EmbMonkAI/offline_prog_open/PCB010-V3.0.pdf

PB12 33 PB13 34 PB14 35 PB15 36 PC6 37 PC7 38 PC8 39 PC9 40 PA8 41 PA9 42 PA10 43 PA11 44 PA12 45 PA13 (JTMSSWDIO) 46 VSS 47 VDD 48 PA¹⁴ ⁽JTCKSWCLK⁾ ⁴⁹ PA¹⁵ ⁽JTDI) 50

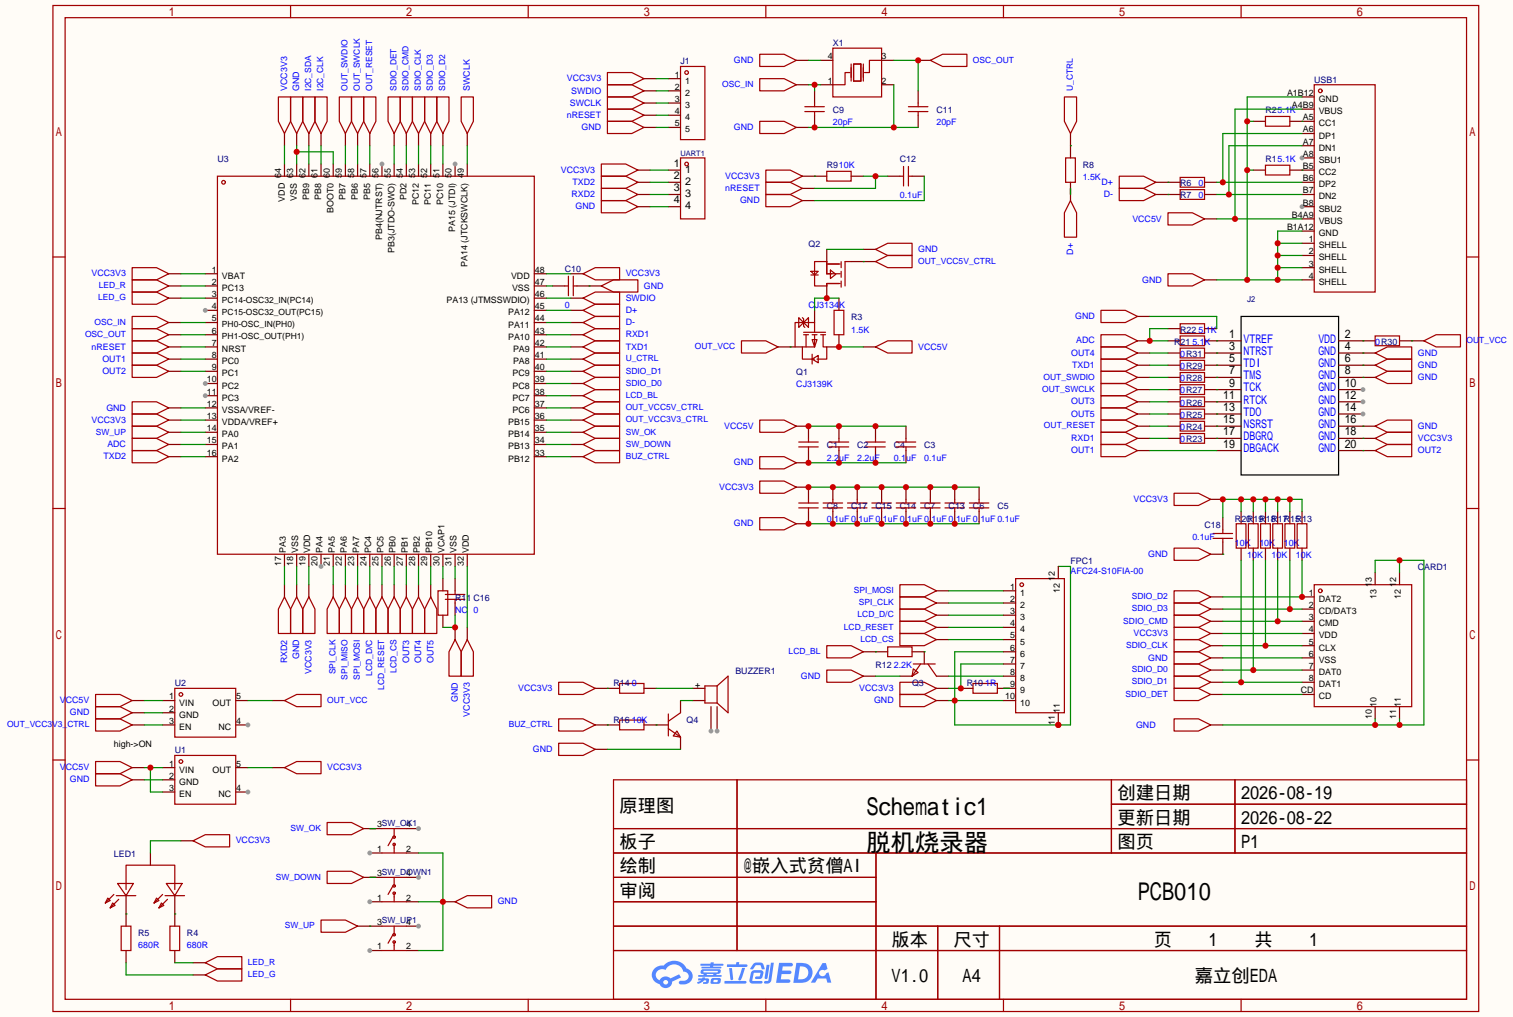
[picture p1: page 1]

原理图 | Schematic1 | 创建日期 | 2026-08-19

更新日期 | 2026-08-22

板子 | 脱机烧录器 | 图页 | P1
绘制 | @嵌入式贫僧AI | PCB010
审阅

V1.0 | A4 | 嘉立创EDA
