EmbMonkAI/offline_prog_open/stm32f401_proj/Core/Inc/main.h

#define LED_R_Pin GPIO_PIN_13
#define LED_R_GPIO_Port GPIOC
#define LED_G_Pin GPIO_PIN_14
#define LED_G_GPIO_Port GPIOC
#define LCD_SDA_Pin GPIO_PIN_4
#define LCD_SDA_GPIO_Port GPIOC
#define LCD_SDAC5_Pin GPIO_PIN_5
#define LCD_SDAC5_GPIO_Port GPIOC
#define LCD_A0_Pin GPIO_PIN_0
#define LCD_A0_GPIO_Port GPIOB
#define LCD_CS_Pin GPIO_PIN_1
#define LCD_CS_GPIO_Port GPIOB
#define LCD_RST_Pin GPIO_PIN_2
#define LCD_RST_GPIO_Port GPIOB
#define USB_CTRL_Pin GPIO_PIN_8
#define USB_CTRL_GPIO_Port GPIOA
#define BUTTON_Pin GPIO_PIN_15
#define BUTTON_GPIO_Port GPIOA
#define SDIO_DET_Pin GPIO_PIN_3
#define SDIO_DET_GPIO_Port GPIOB
#define SWCLK_Pin GPIO_PIN_8
#define SWCLK_GPIO_Port GPIOB
#define SWDIO_Pin GPIO_PIN_9
#define SWDIO_GPIO_Port GPIOB
