EmbMonkAI/offline_prog_open/stm32f401_proj/Core/Src/main.c

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
/* Includes ------------------------------------------------------------------*/
#include "main.h"
#include "fatfs.h"
#include "usb_device.h"

/* USER CODE BEGIN Includes */
#include "app_main.h"
/* USER CODE END Includes */

SD_HandleTypeDef hsd;

SPI_HandleTypeDef hspi1;

TIM_HandleTypeDef htim2;

UART_HandleTypeDef huart1;

void SystemClock_Config(void);
static void MX_GPIO_Init(void);
static void MX_SDIO_SD_Init(void);
static void MX_SPI1_Init(void);
static void MX_USART1_UART_Init(void);
static void MX_TIM2_Init(void);
/**
  * @brief  The application entry point.
  * @retval int
  */
int main(void)
{

  /* MCU Configuration--------------------------------------------------------*/

  /* Reset of all peripherals, Initializes the Flash interface and the Systick. */
  HAL_Init();

  /* Configure the system clock */
  SystemClock_Config();

  /* Initialize all configured peripherals */
  MX_GPIO_Init();
  MX_SDIO_SD_Init();
  MX_SPI1_Init();
  MX_USART1_UART_Init();
  MX_TIM2_Init();
  MX_FATFS_Init();
  MX_USB_DEVICE_Init();
  /* USER CODE BEGIN 2 */
	  HAL_GPIO_WritePin(USB_CTRL_GPIO_Port, USB_CTRL_Pin, GPIO_PIN_SET);

  /* 复位源打印（IWDG/欠压/软复位一眼分辨，产线诊断用）*/
  {
    uint32_t csr = RCC->CSR;
    const char *src = (csr & (1U << 24)) ? "IWDG" :
                      (csr & (1U << 19)) ? "WWDG" :
                      (csr & (1U << 26)) ? "SOFT" :
                      (csr & (1U << 28)) ? "POR" : "?";
    {   /* 必须 bsp_uart_log：裸 printf 无调试器时走半主机会挂死（实测教训）*/
        extern int bsp_uart_log(const char *fmt, ...);
        bsp_uart_log("[RST] src=%s csr=%08lX\n", src, (unsigned long)csr);
    }
  }
  app_main_init();   /* 应用层初始化：装配 LED 设备等 */
  /* USER CODE END 2 */

  /* Infinite loop */
  /* USER CODE BEGIN WHILE */
  while (1)
  {
    /* USER CODE END WHILE */

    /* USER CODE BEGIN 3 */
    app_main_loop();   /* 应用层主循环：LED 闪烁等 */
  }
  /* USER CODE END 3 */
}

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
