EmbMonkAI/offline_prog_open/dap/DAP_config.h

#ifndef __DAP_CONFIG_H__
#define __DAP_CONFIG_H__


#define CPU_CLOCK               84000000        ///< Specifies the CPU Clock in Hz (本工程 STM32F401 @ 84MHz)


#define IO_PORT_WRITE_CYCLES    2               ///< I/O Cycles: 2=default, 1=Cortex-M0+ fast I/0


#define DAP_SWD                 1               ///< SWD Mode:  1 = available, 0 = not available

#define DAP_JTAG                0               ///< JTAG Mode: 0 = not available

#define DAP_JTAG_DEV_CNT        8               ///< Maximum number of JTAG devices on scan chain

#define DAP_DEFAULT_PORT        1               ///< Default JTAG/SWJ Port Mode: 1 = SWD, 2 = JTAG.

#define DAP_DEFAULT_SWJ_CLOCK   10000000         ///< Default SWD/JTAG clock frequency in Hz.


/// Maximum Package Size for Command and Response data.
#define DAP_PACKET_SIZE         64              ///< USB: 64 = Full-Speed, 1024 = High-Speed.

/// Maximum Package Buffers for Command and Response data.
#define DAP_PACKET_COUNT        1              ///< Buffers: 64 = Full-Speed, 4 = High-Speed.


/// Indicate that UART Serial Wire Output (SWO) trace is available.
#define SWO_UART                0               ///< SWO UART:  1 = available, 0 = not available

#define SWO_UART_MAX_BAUDRATE   10000000U       ///< SWO UART Maximum Baudrate in Hz

/// Indicate that Manchester Serial Wire Output (SWO) trace is available.
#define SWO_MANCHESTER          0               ///< SWO Manchester:  1 = available, 0 = not available

#define SWO_BUFFER_SIZE         4096U           ///< SWO Trace Buffer Size in bytes (must be 2^n)


/// Debug Unit is connected to fixed Target Device.
#define TARGET_DEVICE_FIXED     0               ///< Target Device: 1 = known, 0 = unknown;



//**************************************************************************************************
/**
JTAG I/O Pin                 | SWD I/O Pin          | CMSIS-DAP Hardware pin mode
---------------------------- | -------------------- | ---------------------------------------------
TCK: Test Clock              | SWCLK: Clock         | Output Push/Pull
TMS: Test Mode Select        | SWDIO: Data I/O      | Output Push/Pull; Input (for receiving data)
TDI: Test Data Input         |                      | Output Push/Pull
TDO: Test Data Output        |                      | Input
nTRST: Test Reset (optional) |                      | Output Open Drain with pull-up resistor
nRESET: Device Reset         | nRESET: Device Reset | Output Open Drain with pull-up resistor

DAP Hardware I/O Pin Access Functions
*/
#define 	F1XX_PLATFORM		0

#if (F1XX_PLATFORM)
#include "stm32f10x.h"
// Configure DAP I/O pins ------------------------------
#define SWD_GPIO   	GPIOB
#define PIN_SWCLK  	GPIO_Pin_13
#define PIN_SWDIO  	GPIO_Pin_14
#else
#include "stm32f4xx_hal.h"
#define SWD_GPIO   	GPIOB
#define PIN_SWCLK  	GPIO_PIN_6    /* OUT_SWCLK, PB6（PCB010-V3.0） */
#define PIN_SWDIO  	GPIO_PIN_7    /* OUT_SWDIO, PB7（PCB010-V3.0） */
#define PIN_nRESET  GPIO_PIN_5    /* OUT_RESET, PB5（PCB010-V3.0，低有效） */

#define 	PORT_NBR			9
#endif

/** Setup JTAG I/O pins: TCK, TMS, TDI, TDO, nTRST, and nRESET.
 - TCK, TMS, TDI, nTRST, nRESET to output mode and set to high level.
 - TDO to input mode.
*/
static void PORT_JTAG_SETUP(void)
{
#if (DAP_JTAG != 0)
#endif
}

/** Setup SWD I/O pins: SWCLK, SWDIO, and nRESET.
 - SWCLK, SWDIO, nRESET to output mode and set to default high level.
*/
static void PORT_SWD_SETUP(void)
{
#if (F1XX_PLATFORM)	
    GPIO_InitTypeDef GPIO_InitStruct;
	
	SWD_GPIO->BSRR = PIN_SWCLK | PIN_SWDIO;
	
	GPIO_InitStruct.GPIO_Pin = PIN_SWCLK | PIN_SWDIO;
	GPIO_InitStruct.GPIO_Mode = GPIO_Mode_Out_PP;
	GPIO_InitStruct.GPIO_Speed = GPIO_Speed_50MHz;
	GPIO_Init(SWD_GPIO, &GPIO_InitStruct);
	#else
  GPIO_InitTypeDef GPIO_InitStruct = {0};

  /* GPIO Ports Clock Enable */
	SWD_GPIO->BSRR = PIN_SWCLK | PIN_SWDIO | PIN_nRESET;   /* SWCLK/SWDIO/nRESET 默认高 */

  GPIO_InitStruct.Pin = PIN_SWCLK | PIN_SWDIO | PIN_nRESET;
  GPIO_InitStruct.Mode = GPIO_MODE_OUTPUT_PP;
  GPIO_InitStruct.Pull = GPIO_NOPULL;
  GPIO_InitStruct.Speed = GPIO_SPEED_FREQ_HIGH;
  HAL_GPIO_Init(SWD_GPIO, &GPIO_InitStruct);

	
	#endif	
}

/** Disable JTAG/SWD I/O Pins.
 - TCK/SWCLK, TMS/SWDIO, TDI, TDO, nTRST, nRESET to High-Z mode.
*/
static void PORT_OFF(void)
{
	#if (F1XX_PLATFORM)	
	GPIO_InitTypeDef GPIO_InitStruct;
	
	GPIO_InitStruct.GPIO_Pin = PIN_SWCLK | PIN_SWDIO;
	GPIO_InitStruct.GPIO_Mode = GPIO_Mode_IN_FLOATING;
	GPIO_Init(SWD_GPIO, &GPIO_InitStruct);
	#else
  GPIO_InitTypeDef GPIO_InitStruct = {0};
	
  GPIO_InitStruct.Pin = PIN_SWCLK |PIN_SWDIO;
  GPIO_InitStruct.Mode = GPIO_MODE_ANALOG;
  GPIO_InitStruct.Pull = GPIO_NOPULL;
  HAL_GPIO_Init(SWD_GPIO, &GPIO_InitStruct);		
	
	#endif	
}


// SWCLK/TCK I/O pin -------------------------------------

// Current status of the SWCLK/TCK DAP hardware I/O pin
static __inline uint32_t PIN_SWCLK_TCK_IN(void)
{
    return (SWD_GPIO->ODR & PIN_SWCLK) ? 1 : 0;
}

static __inline void PIN_SWCLK_TCK_SET(void)
{
	SWD_GPIO->BSRR = PIN_SWCLK;
}

static __inline void PIN_SWCLK_TCK_CLR(void)
{
	#if (F1XX_PLATFORM)	
    SWD_GPIO->BRR  = PIN_SWCLK;
	#else
		SWD_GPIO->BSRR = (uint32_t)(PIN_SWCLK <<16);
	#endif
}


// SWDIO/TMS Pin I/O --------------------------------------

// Current status of the SWDIO/TMS DAP hardware I/O pin
static __inline uint32_t PIN_SWDIO_TMS_IN(void)
{
    return (SWD_GPIO->IDR & PIN_SWDIO) ? 1 : 0;
}

static __inline void PIN_SWDIO_TMS_SET(void)
{
    SWD_GPIO->BSRR = PIN_SWDIO;
}

static __inline void PIN_SWDIO_TMS_CLR(void)
{
	#if (F1XX_PLATFORM)	
    SWD_GPIO->BRR  = PIN_SWDIO;
	#else
		SWD_GPIO->BSRR = (uint32_t)(PIN_SWDIO <<16);
	#endif	
}


static __inline uint32_t PIN_SWDIO_IN(void)
{
    return (SWD_GPIO->IDR & PIN_SWDIO) ? 1 : 0;
}

static __inline void PIN_SWDIO_OUT(uint32_t bit)
{
    if(bit & 1) SWD_GPIO->BSRR = PIN_SWDIO;
    else
			#if (F1XX_PLATFORM)	
			SWD_GPIO->BRR  = PIN_SWDIO;
			#else
			SWD_GPIO->BSRR = (uint32_t)(PIN_SWDIO <<16);
			#endif		
}

static __inline void PIN_SWDIO_OUT_ENABLE(void)
{
#if (F1XX_PLATFORM)	
	SWD_GPIO->CRH &= ~(0xF << (14 - 8) * 4);
  SWD_GPIO->CRH |=  (0x3 << (14 - 8) * 4);
	SWD_GPIO->BRR  = PIN_SWDIO;
#else

  GPIO_InitTypeDef GPIO_InitStruct = {0};	
  GPIO_InitStruct.Pin = PIN_SWDIO;
  GPIO_InitStruct.Mode = GPIO_MODE_OUTPUT_PP;
	GPIO_InitStruct.Speed = GPIO_SPEED_FREQ_MEDIUM;	
  HAL_GPIO_Init(SWD_GPIO, &GPIO_InitStruct);
	SWD_GPIO->BSRR  = PIN_SWDIO<<16;
#endif
}

static __inline void PIN_SWDIO_OUT_DISABLE(void)
{
#if (F1XX_PLATFORM)	
  SWD_GPIO->CRH &= ~(0xF << (14 - 8) * 4);
	SWD_GPIO->CRH |=  (0x8 << (14 - 8) * 4);
	SWD_GPIO->BSRR = PIN_SWDIO;
#else
	
  GPIO_InitTypeDef GPIO_InitStruct = {0};
  GPIO_InitStruct.Pin = PIN_SWDIO;
  GPIO_InitStruct.Mode = GPIO_MODE_INPUT;
	GPIO_InitStruct.Speed = GPIO_SPEED_FREQ_MEDIUM;	
  HAL_GPIO_Init(SWD_GPIO, &GPIO_InitStruct);
	SWD_GPIO->BSRR = PIN_SWDIO;	
#endif	
}


// TDI Pin I/O ---------------------------------------------

static __inline uint32_t PIN_TDI_IN(void)
{
#if (DAP_JTAG != 0)
#endif
	return 0;
}

static __inline void PIN_TDI_OUT(uint32_t bit)
{
#if (DAP_JTAG != 0)
#endif
}


// TDO Pin I/O ---------------------------------------------

static __inline uint32_t PIN_TDO_IN(void)
{
#if (DAP_JTAG != 0)
#endif
	return 0;
}


// nTRST Pin I/O -------------------------------------------

static __inline uint32_t PIN_nTRST_IN(void)
{
    return 0;
}

static __inline void PIN_nTRST_OUT(uint32_t bit)
{
}

// nRESET Pin I/O------------------------------------------  目标硬复位 nRESET, PB7(低有效)
static __inline uint32_t PIN_nRESET_IN(void)
{
    return (SWD_GPIO->IDR & PIN_nRESET) ? 1 : 0;
}

static __inline void PIN_nRESET_OUT(uint32_t bit)
{
    if (bit & 1) SWD_GPIO->BSRR = PIN_nRESET;           /* 1=释放复位(高) */
    else         SWD_GPIO->BSRR = (PIN_nRESET << 16);   /* 0=复位(低) */
}


//**************************************************************************************************
/** Connect LED: is active when the DAP hardware is connected to a debugger
    Running LED: is active when program execution in target started
*/

static __inline void LED_CONNECTED_OUT(uint32_t bit)
{
}

static __inline void LED_RUNNING_OUT(uint32_t bit)
{
}



static void DAP_SETUP(void)
{
	#if (F1XX_PLATFORM)
	RCC_APB2PeriphClockCmd(RCC_APB2Periph_GPIOB, ENABLE);
	#endif
	
	PORT_OFF();
}


static uint32_t RESET_TARGET(void)
{
    return (0);              // change to '1' when a device reset sequence is implemented
}


#endif // __DAP_CONFIG_H__
