EmbMonkAI/offline_prog_open/app/ui_font_16.h

/**
 * @file ui_font_16.h
 * @brief 内置点阵字库 16 号（A/B 比对用；观感=原 SD 字库 16×16）
 *
 * 由 tools/opfp_gen/gen_font_16.py 从 modules/app/font_config/
 * kp_font_lib.bin 直接提取（V2.2.0 之前固件加载的原点阵）——勿手改。
 * 符号名/查找 API 与 ui_font_24.h 完全同名，二者不可同时 include；
 * app_ui.c 经 UI_FONT_SEL 宏二选一（改宏重编译切换比对）。
 *
 * 汉字 40 字 16×16（每字 32B，2 页×16 列字节，GB2312 码索引）
 * ASCII 95 字 8×16（每字 16B，0x20~0x7E 顺序索引）
 */
#ifndef __UI_FONT_16_H
#define __UI_FONT_16_H

#include <stdint.h>

#define UIF_CHS_N      40
#define UIF_CHS_W      16
#define UIF_CHS_H      16
#define UIF_CHS_BYTES  32
#define UIF_ASC_FIRST  0x20
#define UIF_ASC_N      95
#define UIF_ASC_W      8
#define UIF_ASC_H      16
#define UIF_ASC_BYTES  16

/* 汉字 GB2312 码表（升序；查找用二分或线性）*/
static const uint16_t uif_chs_code[UIF_CHS_N] = {
    0xA1FA,0xB0B4,0xB0DC,0xB1A3,0xB3C9,0xB3CC,0xB4CE,0xB5D8,0xB7B5,0xB9A6,0xB9CC,0xB9D8,
    0xB9F6,0xB9FD,0xBBA4,0xBBD8,0xBCFE,0xBFAA,0xC2BC,0xC2EB,0xC6AC,0xC8B7,0xC8CF,0xC9D5,
    0xCAA7,0xCABC,0xCAFD,0xCDA8,0xCEC4,0xCEDE,0xCFDE,0xD0A3,0xD0BE,0xD0F2,0xD1A1,0xD1E9,
    0xD4F1,0xD6B7,0xD6C6,0xD6D0,
};

static const uint8_t uif_chs_bits[UIF_CHS_N][UIF_CHS_BYTES] = {
    { /* 0xA1FA */
        0x80,0x80,0x80,0x80,0x80,0x80,0x80,0x80,0x80,0x80,0xE0,0xE0,0xC0,0xC0,0x80,0x80,
        0x00,0x00,0x00,0x00,0x00,0x00,0x00,0x00,0x00,0x00,0x03,0x03,0x01,0x01,0x00,0x00,
    },
    { /* 0xB0B4 */
        0x00,0x10,0x10,0xFE,0x10,0x00,0xB8,0x88,0x88,0xEA,0x8C,0x88,0x88,0xB8,0x00,0x00,
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
    },
    { /* 'y' 0x79 */
        0x80,0x80,0x80,0x80,0x00,0x80,0x80,0x80,
        0x80,0x81,0x8F,0xFE,0x78,0x1E,0x07,0x01,
    },
    { /* 'z' 0x7A */
        0x00,0x80,0x80,0x80,0x80,0x80,0x80,0x80,
        0x00,0x21,0x31,0x3C,0x2E,0x23,0x31,0x30,
    },
    { /* '{' 0x7B */
        0x00,0x00,0x00,0x00,0x80,0xFC,0x7E,0x02,
        0x00,0x00,0x00,0x00,0x00,0x3F,0x7F,0x40,
    },
    { /* '|' 0x7C */
        0x00,0x00,0x00,0x00,0xFF,0xFF,0x00,0x00,
        0x00,0x00,0x00,0x00,0xFF,0xFF,0x00,0x00,
    },
    { /* '}' 0x7D */
        0x00,0x02,0x02,0x7E,0xFC,0x80,0x00,0x00,
        0x00,0x40,0x40,0x7F,0x3F,0x00,0x00,0x00,
    },
    { /* '~' 0x7E */
        0x00,0x06,0x07,0x01,0x03,0x02,0x06,0x04,
        0x00,0x00,0x00,0x00,0x00,0x00,0x00,0x00,
    },
};

/* 取汉字（GBK 双字节码，高字节在 s[0]）点阵指针；未收录返回 NULL */
static const uint8_t *uif_chs(uint8_t hi, uint8_t lo)
{
    uint16_t code = (uint16_t)((hi << 8) | lo);
    for (uint16_t i = 0; i < UIF_CHS_N; i++)
        if (uif_chs_code[i] == code)
            return uif_chs_bits[i];
    return 0;
}

/* 取 ASCII（0x20~0x7E）点阵指针；范围外返回 NULL */
static const uint8_t *uif_asc(uint8_t c)
{
    if (c < UIF_ASC_FIRST || c >= UIF_ASC_FIRST + UIF_ASC_N)
        return 0;
    return uif_asc_bits[c - UIF_ASC_FIRST];
}

#endif /* __UI_FONT_16_H */
