EmbMonkAI/offline_prog_open/app/ui_font_20.h

/**
 * @file ui_font_20.h
 * @brief 内置点阵字库 20 号（SD 字库同源放大，V2.2.5）
 *
 * 由 tools/opfp_gen/gen_font_sd.py 生成：kp_font_lib.bin
 * 16×16 区 ×1.25（4:5 映射）——观感与 16 号（SD 库原点阵）同字体。
 * 勿手改；增删 UI 文案后重跑生成工具。
 *
 * 汉字 40 字 20×20（列页格式，GB2312 码索引）
 * ASCII 95 字 10×20（0x20~0x7E 顺序索引）
 */
#ifndef __UI_FONT_20_H
#define __UI_FONT_20_H

#include <stdint.h>

#define UIF_CHS_N      40
#define UIF_CHS_W      20
#define UIF_CHS_H      20
#define UIF_CHS_BYTES  60
#define UIF_ASC_FIRST  0x20
#define UIF_ASC_N      95
#define UIF_ASC_W      10
#define UIF_ASC_H      20
#define UIF_ASC_BYTES  30

/* 汉字 GB2312 码表（升序；查找用二分或线性）*/
static const uint16_t uif_chs_code[UIF_CHS_N] = {
    0xA1FA,0xB0B4,0xB0DC,0xB1A3,0xB3C9,0xB3CC,0xB4CE,0xB5D8,0xB7B5,0xB9A6,0xB9CC,0xB9D8,
    0xB9F6,0xB9FD,0xBBA4,0xBBD8,0xBCFE,0xBFAA,0xC2BC,0xC2EB,0xC6AC,0xC8B7,0xC8CF,0xC9D5,
    0xCAA7,0xCABC,0xCAFD,0xCDA8,0xCEC4,0xCEDE,0xCFDE,0xD0A3,0xD0BE,0xD0F2,0xD1A1,0xD1E9,
    0xD4F1,0xD6B7,0xD6C6,0xD6D0,
};

static const uint8_t uif_chs_bits[UIF_CHS_N][UIF_CHS_BYTES] = {
    { /* 0xA1FA */
        0x00,0x00,0x00,0x00,0x00,0x00,0x00,0x00,0x00,0x00,0x00,0x00,0x00,0x80,0x80,0x00,0x00,0x00,0x00,0x00,
        0x02,0x02,0x02,0x02,0x02,0x02,0x02,0x02,0x02,0x02,0x02,0x02,0x02,0x1F,0x1F,0x0F,0x0F,0x0F,0x02,0x02,
        0x00,0x00,0x00,0x00,0x00,0x00,0x00,0x00,0x00,0x00,0x00,0x00,0x00,0x00,0x00,0x00,0x00,0x00,0x00,0x00,
    },
    { /* 0xB0B4 */
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
            return uif_chs_bits[i];
    return 0;
}

/* 取 ASCII（0x20~0x7E）点阵指针；范围外返回 NULL */
static const uint8_t *uif_asc(uint8_t c)
{
    if (c < UIF_ASC_FIRST || c >= UIF_ASC_FIRST + UIF_ASC_N)
        return 0;
    return uif_asc_bits[c - UIF_ASC_FIRST];
}

#endif /* __UI_FONT_20_H */
