EmbMonkAI/offline_prog_open/app/app_util.c

/**
 * @file app_util.c
 * @brief app 层公共小工具实现
 */

#include "app_util.h"

uint32_t app_util_crc32(uint32_t crc, const uint8_t *data, uint32_t len)
{
    crc = ~crc;
    for (uint32_t i = 0; i < len; i++) {
        crc ^= data[i];
        for (int b = 0; b < 8; b++)
            crc = (crc >> 1) ^ (0xEDB88320U & (0U - (crc & 1U)));
    }
    return ~crc;
}
