EmbMonkAI/offline_prog_open/(commit log)

2026-08-09 chore: 工程骨架——CubeMX 生成基础(HAL/CMSIS/中间件) + 原理图 PCB010-V3.0 + MIT License
    - STM32F401RB 平台基础：HAL 驱动库 + CMSIS + USB Device / FatFs 中间件
    - 原理图 PDF（V3.0，带品牌署名）
    - MIT License，Copyright (c) 2026 嵌入式贫僧AI（微信：EmbMonkAI）
    作者：嵌入式贫僧AI（微信：EmbMonkAI）
2026-08-09 feat(modules): 嵌入式框架层——设备/组件/服务分层 + PC 模拟器 + CMake
    - component: gen_log 日志抽象、font_mgr 字库管理
    - device: LED/按键/蜂鸣器/LCD(ST7789)/字体 设备抽象
    - service: display 显示服务
    - app: UI 视图(文件列表/参数/烧录页) + 字库配置
    - sim + cmake: PC 模拟测试支撑
    - 分层约定：modules 通用，业务画面在 app/，BSP 注入平台实现
    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
2026-08-09 feat(bsp): 板级支持包——GPIO/UART/蜂鸣器 适配 + 硬件说明文档
    - bsp_gpio: 通用 HAL GPIO（set/get/input/output，注入所有设备）
    - bsp_uart: 日志输出（USART1 PA9/PA10 115200）
    - bsp_buzzer: TIM2_CH3 PWM 适配（PA2，2.7kHz）
    - HARDWARE.md: 硬件资源与引脚说明
    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
2026-08-09 feat(dap): CMSIS-DAP/SWD 主机——脱机烧录核心 + Flash 算法 blob
    - DAP.c/JTAG_DP.c/SW_DP.c/SWO.c: CMSIS-DAP 固件核心（参考 ARM CMSIS_5）
    - SWD_host.c: SWD 原语（read/write word/memory, syscall exec）
    - algo/flash_blob.h: Flash 编程算法 blob（数据化，按 .opfp 文件携带）
    - SWD 时钟 10MHz；nRESET 不驱动（PB7 高阻），复位走 AIRCR 软件复位
    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
2026-08-09 feat(target): 目标芯片抽象层——.opfp 工程文件格式 + 通用烧录流程
    - target.h: target_chip_t 芯片对象 + transport_ops_t 传输接口（可插拔 SWD）
    - target_program.c: connect→halt→下载 algo→erase/program→verify→reset 通用流程
    - transport_swd.c: DAP 原语薄包装
    - opfp.h: .opfp v5 二进制格式（header + PGCF 配置段 + algo + firmware + CRC32）
    - RDP 读保护处理为预留接口（app_rdp.c）
    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
2026-08-10 feat(core): CubeMX 应用工程——外设初始化 + Keil MDK-ARM 工程
    - stm32f401_proj.ioc: CubeMX 配置（84MHz 时钟树/SDIO 4bit/SPI1/USART1/TIM2/USB OTG）
    - Core/: main.c + 中断 + MSP + 系统配置（USER CODE 区接入 app_main）
    - MDK-ARM/: Keil 工程文件（.uvprojx），F7 编译 F8 下载
    - FATFS/Target: diskio → HAL_SD 桥接
    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
2026-08-30 feat(app): 应用层——脱机烧录全流程 UI + 安全体系 + USB 传输
    - app_main: 装配与主循环（TFT 自检→UI 轮询），固件版本号 V2.2.5
    - app_flash: .opfp 解析/烧录执行（v5 校验、坏段拒烧、进度回调）
    - app_ui: 三键 UI（文件选择/烧录页），内置字库（ui_font_*.h）
    - app_usb: CDC 停等式传输协议（BEGIN/DATA/EOF + CRC32，busy 拒绝）
    - app_sec: 设备端加密（AES-CTR+CMAC，口令+UID 双因子，Sector5 持久化）
    - app_count: 烧录计数持久化（Sector4，append-only + 压缩重写）
    - app_rdp: 读保护检测（预留接口，开源版不含解锁算法）
    - app_util: 杂项
    作者：嵌入式贫僧AI（微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
2026-09-08 feat(tools): PC 端工具——.opfp 生成器 GUI + 芯片库 + 字库生成
    - opfp_generator.py: PySide6 四区布局 GUI（芯片选型/滚码次数配置/导入导出/USB 发送）
    - usbproto.py + opfp_transfer.py: USB CDC 传输协议 PC 端（QThread 后台发送）
    - build_chip_db.py: probe-rs YAML → chips.json（3726 芯片/278 算法）
    - gen_font_16/sd/demo.py: 内置字库 ui_font_*.h 生成工具
    - chips.json: 3726 款 ARM Cortex-M 芯片库（3MB）
    - tests: GUI offscreen 冒烟 + v5 字节布局断言（31 项）
    - 可用 PyInstaller 打包免安装 exe（README 见用法）
    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
2026-09-09 docs: README——项目说明 / 快速开始 / 引脚表 / 开发日志 / 联系方式
    - 功能特性、硬件清单（BOM）、工具链、快速开始（exe 免安装 / 源码两种方式）
    - 引脚分配表、开发日志（38 个里程碑完整演进史）
    - 作者：嵌入式贫僧AI（微信号 EmbMonkAI，全网同名）
    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
2026-09-09 fix(core): 补齐 CubeMX 中间件应用层——FATFS/USB_DEVICE 配置与桥接
    - FATFS/App+Target: ffconf.h 配置（LFN=2）、sd_diskio → HAL_SD 桥接、bsp_driver_sd
    - USB_DEVICE/App+Target: CDC 类应用（usbd_cdc_if 收发、usbd_desc 描述符、usb_device）
    - .mxproject: CubeMX 增量生成状态
    - tools/ai_flash_loop: JLink 烧录+串口断言闭环脚本
    - modules/app/font_config/kp_font_lib.bin: 字库源文件（gen_font_* 输入）
    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
    [flash_and_check.py]
2026-09-09 chore: 字库源文件入库——gitignore 加例外规则
    kp_font_lib.bin 是 gen_font_16/sd.py 的输入（生成 app/ui_font_*.h），
    被 *.bin 全局规则误伤，加 ! 例外。pc/pcb 两个工作区杂文件不入库。
    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
2026-09-12 chore: gitignore 忽略本地 docs/ 内部档案目录
